szymonkacperek/PSD_Dashboard/Projekt_EAGLE/0.1.brd

## EAGLE design Projekt_EAGLE/0.1.brd (2020-08-10)

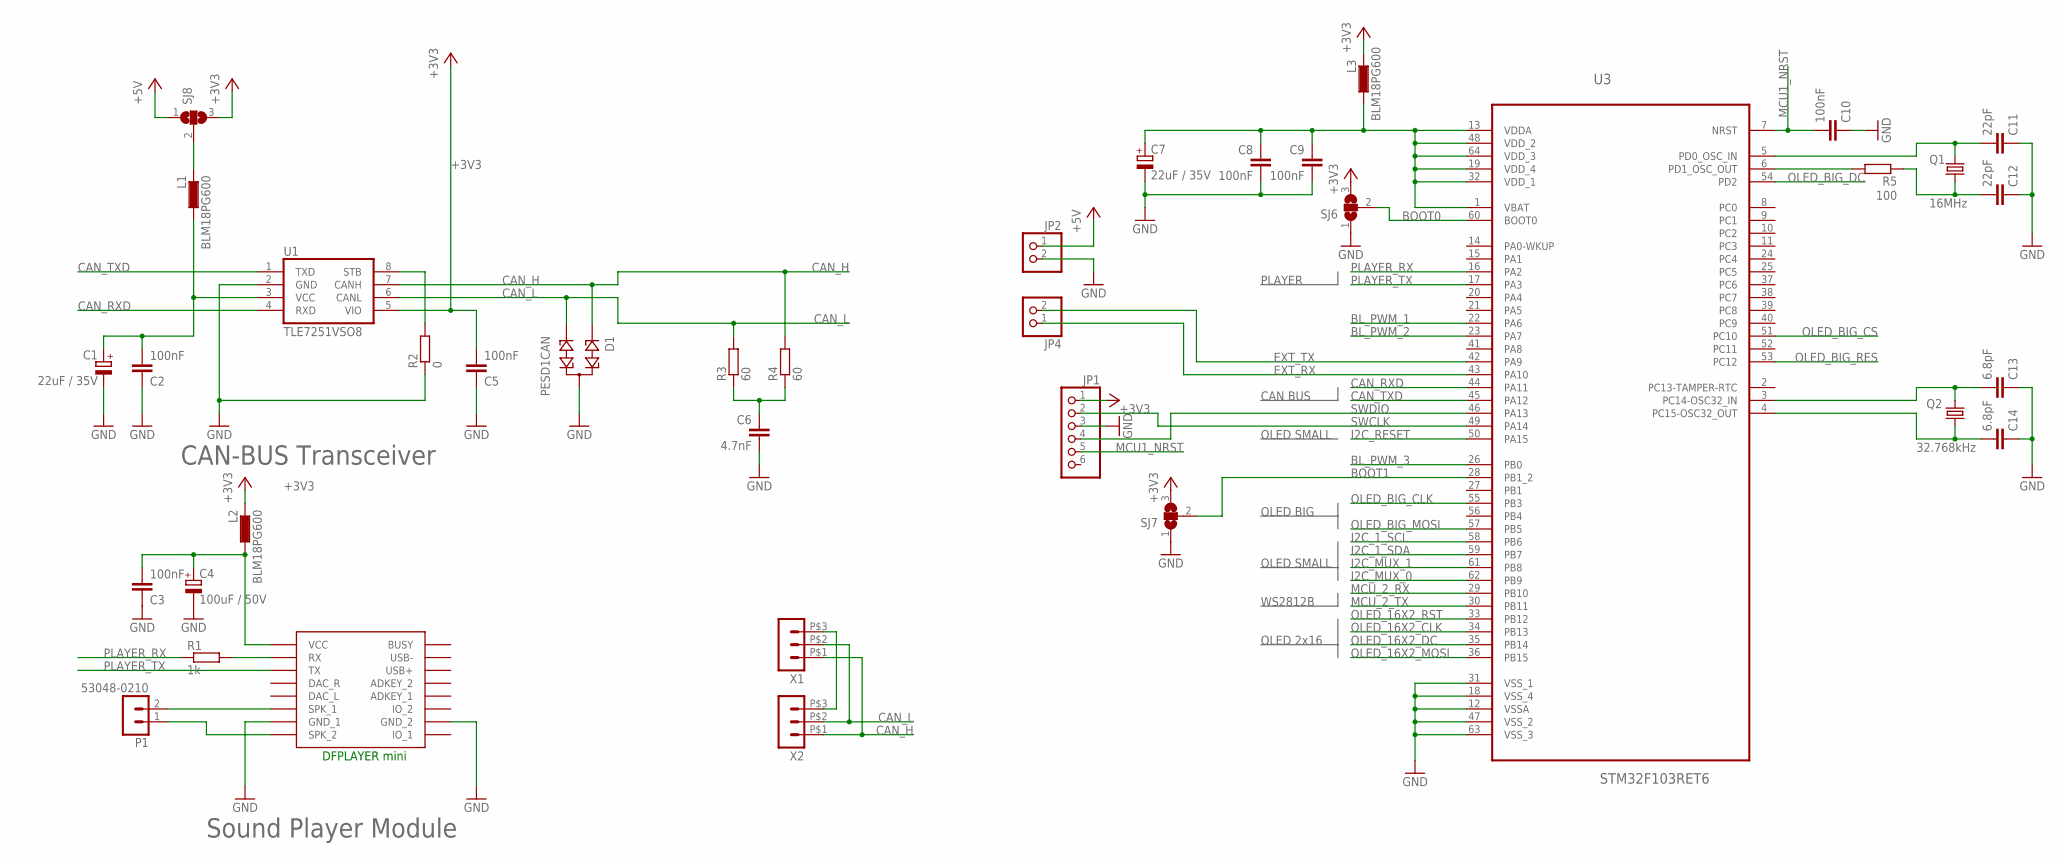
[picture p1: schematic 0.1.sch, sheet 1, MCU]

Parts:
C1, C7: 22uF / 35V; SMC_D
C2, C3, C5, C8, C9, C10: 100nF; C0805K
C4: 100uF / 50V; PANASONIC_F
C6: 4.7nF; C0805K
C11, C12: 22pF; C0805K
C13, C14: 6.8pF; C0805K
D1: PESD1CAN; SOT23
JP1: PINHD-1X6; 1X06
JP2, JP4: PINHD-1X2; 1X02
L1, L2, L3: BLM18PG600; L1608
P1: 53048-0210
Q1: 16MHz; SM49
Q2: 32.768kHz; SMD4_270
R1: 1k; R0805
R2: 0; R0805
R3, R4: 60; R0805
R5: 100; R0805
SJ6, SJ7, SJ8: SJ2W; SJ_2
U1: TLE7251VSO8; SO8
U2: DFPLAYER
U3: STM32F103RET6; QFP50P1200X1200X160-64N
X1, X2: HEADER_POS3_43650-0315; 43650-0315

Connections:
+3V3: C5.2, JP1.1, L2.2, L3.2, SJ6.3, SJ7.3, SJ8.3, U1.5 (VIO); also elsewhere on the board
+5V: JP2.1, SJ8.1; also elsewhere on the board
BL_PWM_1: U3.22 (PA6); also elsewhere on the board
BL_PWM_2: U3.23 (PA7); also elsewhere on the board
BL_PWM_3: U3.26 (PB0); also elsewhere on the board
BOOT0: SJ6.2, U3.60 (BOOT0)
BOOT1: SJ7.2, U3.28 (PB1_2)
CAN_H: D1.1, R4.2, U1.7 (CANH), X1.P$1 (1), X2.P$1 (1)
CAN_L: D1.2, R3.2, U1.6 (CANL), X1.P$2 (2), X2.P$2 (2)
CAN_RXD: U1.4 (RXD), U3.44 (PA11)
CAN_STB: R2.2, U1.8 (STB)
CAN_TXD: U1.1 (TXD), U3.45 (PA12)
EXT_RX: JP4.1, U3.43 (PA10)
EXT_TX: JP4.2, U3.42 (PA9)
GND: C1.-, C2.1, C3.1, C4.-, C5.1, C6.2, C7.-, C8.2, C9.2, C10.1, C11.1, C12.1, C13.1, C14.1, D1.3, JP1.3, JP2.2, R2.1, SJ6.1, SJ7.1, U1.2 (GND), U2.GND_1, U2.GND_2, U3.12 (VSSA), U3.18 (VSS_4), U3.31 (VSS_1), U3.47 (VSS_2), U3.63 (VSS_3); also elsewhere on the board
I2C_1_SCL: U3.58 (PB6); also elsewhere on the board
I2C_1_SDA: U3.59 (PB7); also elsewhere on the board
I2C_MUX_0: U3.62 (PB9); also elsewhere on the board
I2C_MUX_1: U3.61 (PB8); also elsewhere on the board
I2C_RESET: U3.50 (PA15); also elsewhere on the board
MCU1_NRST: C10.2, JP1.5, U3.7 (NRST)
MCU_2_RX: U3.29 (PB10); also elsewhere on the board
MCU_2_TX: U3.30 (PB11); also elsewhere on the board
unnamed: R5.2, U3.6 (PD1_OSC_OUT)
unnamed: R1.2, U2.RX
unnamed: C3.2, C4.+, L2.1, U2.VCC
unnamed: X1.P$3 (3), X2.P$3 (3)
unnamed: P1.1, U2.SPK2 (SPK_2)
unnamed: C6.1, R3.1, R4.1
unnamed: C7.+, C8.1, C9.1, L3.1, U3.1 (VBAT), U3.13 (VDDA), U3.19 (VDD_4), U3.32 (VDD_1), U3.48 (VDD_2), U3.64 (VDD_3)
unnamed: P1.2, U2.SPK1 (SPK_1)
unnamed: L1.2, SJ8.2
unnamed: C11.2, Q1.1, U3.5 (PD0_OSC_IN)
unnamed: C12.2, Q1.2, R5.1
unnamed: C13.2, Q2.4 (2), U3.3 (PC14-OSC32_IN)
unnamed: C14.2, Q2.1, U3.4 (PC15-OSC32_OUT)
unnamed: C1.+, C2.2, L1.1, U1.3 (VCC)
OLED_16X2_CLK: U3.34 (PB13); also elsewhere on the board
OLED_16X2_DC: U3.35 (PB14); also elsewhere on the board
OLED_16X2_MOSI: U3.36 (PB15); also elsewhere on the board
OLED_16X2_RST: U3.33 (PB12); also elsewhere on the board
OLED_BIG_CLK: U3.55 (PB3); also elsewhere on the board
OLED_BIG_CS: U3.51 (PC10); also elsewhere on the board
OLED_BIG_DC: U3.54 (PD2); also elsewhere on the board
OLED_BIG_MOSI: U3.57 (PB5); also elsewhere on the board
OLED_BIG_RES: U3.53 (PC12); also elsewhere on the board
PLAYER_RX: R1.1, U3.16 (PA2)
PLAYER_TX: U2.TX, U3.17 (PA3)
SWCLK: JP1.2, U3.49 (PA14)
SWDIO: JP1.4, U3.46 (PA13)

Notes on the sheet:
CAN-BUS Transceiver
Sound Player Module
OLED 2x16
OLED BIG
OLED SMALL
PLAYER
WS2812B
CAN BUS
DFPLAYER mini

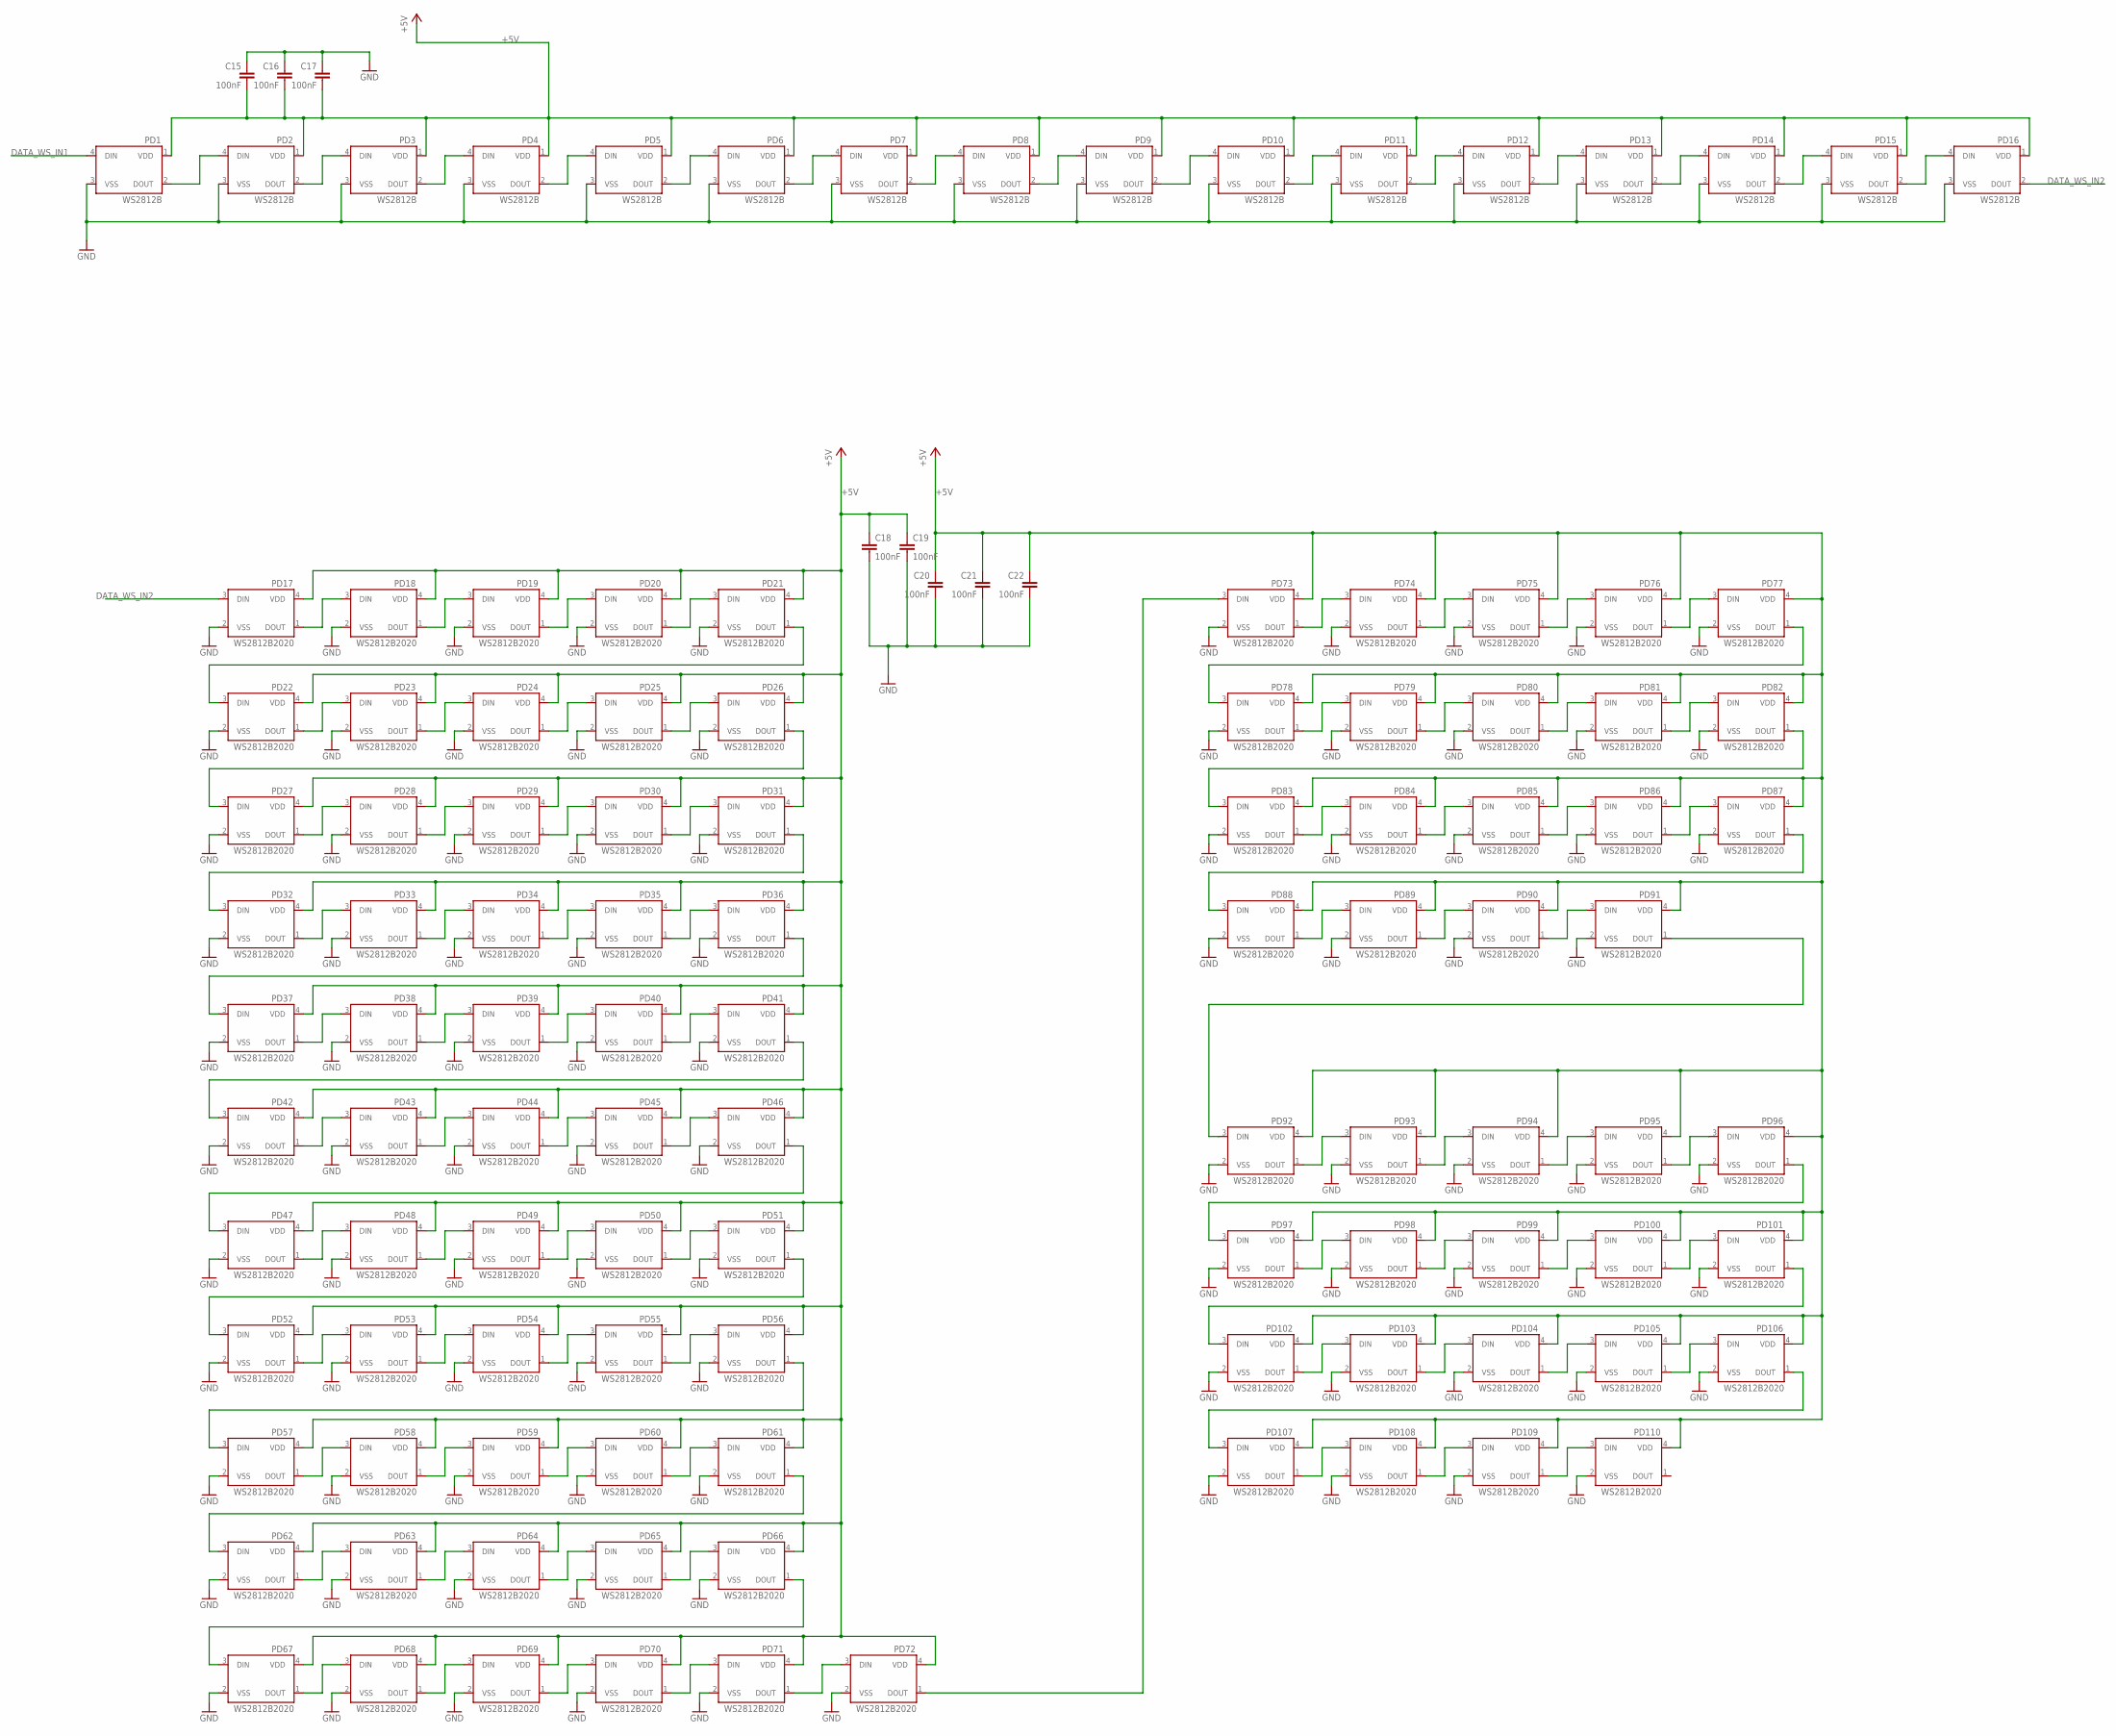
[picture p2: schematic 0.1.sch, sheet 2, WS2812b arrays]

Parts:
C15, C16, C17, C18, C19, C20, C21, C22: 100nF; C0805K
PD1, PD2, PD3, PD4, PD5, PD6, PD7, PD8, PD9, PD10, PD11, PD12, PD13, PD14, PD15, PD16: WS2812B; 5050
PD17, PD18, PD19, PD20, PD21, PD22, PD23, PD24, PD25, PD26, PD27, PD28, PD29, PD30, PD31, PD32, PD33, PD34, PD35, PD36, PD37, PD38, PD39, PD40, PD41, PD42, PD43, PD44, PD45, PD46, PD47, PD48, PD49, PD50, PD51, PD52, PD53, PD54, PD55, PD56, PD57, PD58, PD59, PD60, PD61, PD62, PD63, PD64, PD65, PD66, PD67, PD68, PD69, PD70, PD71, PD72, PD73, PD74, PD75, PD76, PD77, PD78, PD79, PD80, PD81, PD82, PD83, PD84, PD85, PD86, PD87, PD88, PD89, PD90, PD91, PD92, PD93, PD94, PD95, PD96, PD97, PD98, PD99, PD100, PD101, PD102, PD103, PD104, PD105, PD106, PD107, PD108, PD109, PD110: WS2812B2020; LED_WS2812-2020

Connections:
+5V: C15.2, C16.2, C17.2, C18.1, C19.1, C20.1, C21.1, C22.1, PD1.1 (VDD), PD2.1 (VDD), PD3.1 (VDD), PD4.1 (VDD), PD5.1 (VDD), PD6.1 (VDD), PD7.1 (VDD), PD8.1 (VDD), PD9.1 (VDD), PD10.1 (VDD), PD11.1 (VDD), PD12.1 (VDD), PD13.1 (VDD), PD14.1 (VDD), PD15.1 (VDD), PD16.1 (VDD), PD17.4 (VDD), PD18.4 (VDD), PD19.4 (VDD), PD20.4 (VDD), PD21.4 (VDD), PD22.4 (VDD), PD23.4 (VDD), PD24.4 (VDD), PD25.4 (VDD), PD26.4 (VDD), PD27.4 (VDD), PD28.4 (VDD), PD29.4 (VDD), PD30.4 (VDD), PD31.4 (VDD), PD32.4 (VDD), PD33.4 (VDD), PD34.4 (VDD), PD35.4 (VDD), PD36.4 (VDD), PD37.4 (VDD), PD38.4 (VDD), PD39.4 (VDD), PD40.4 (VDD), PD41.4 (VDD), PD42.4 (VDD), PD43.4 (VDD), PD44.4 (VDD), PD45.4 (VDD), PD46.4 (VDD), PD47.4 (VDD), PD48.4 (VDD), PD49.4 (VDD), PD50.4 (VDD), PD51.4 (VDD), PD52.4 (VDD), PD53.4 (VDD), PD54.4 (VDD), PD55.4 (VDD), PD56.4 (VDD), PD57.4 (VDD), PD58.4 (VDD), PD59.4 (VDD), PD60.4 (VDD), PD61.4 (VDD), PD62.4 (VDD), PD63.4 (VDD), PD64.4 (VDD), PD65.4 (VDD), PD66.4 (VDD), PD67.4 (VDD), PD68.4 (VDD), PD69.4 (VDD), PD70.4 (VDD), PD71.4 (VDD), PD72.4 (VDD), PD73.4 (VDD), PD74.4 (VDD), PD75.4 (VDD), PD76.4 (VDD), PD77.4 (VDD), PD78.4 (VDD), PD79.4 (VDD), PD80.4 (VDD), PD81.4 (VDD), PD82.4 (VDD), PD83.4 (VDD), PD84.4 (VDD), PD85.4 (VDD), PD86.4 (VDD), PD87.4 (VDD), PD88.4 (VDD), PD89.4 (VDD), PD90.4 (VDD), PD91.4 (VDD), PD92.4 (VDD), PD93.4 (VDD), PD94.4 (VDD), PD95.4 (VDD), PD96.4 (VDD), PD97.4 (VDD), PD98.4 (VDD), PD99.4 (VDD), PD100.4 (VDD), PD101.4 (VDD), PD102.4 (VDD), PD103.4 (VDD), PD104.4 (VDD), PD105.4 (VDD), PD106.4 (VDD), PD107.4 (VDD), PD108.4 (VDD), PD109.4 (VDD), PD110.4 (VDD); also elsewhere on the board
DATA_WS_IN1: PD1.4 (DIN); also elsewhere on the board
DATA_WS_IN2: PD16.2 (DOUT), PD17.3 (DIN)
DATA_WS_IN3: PD72.1 (DOUT), PD73.3 (DIN)
GND: C15.1, C16.1, C17.1, C18.2, C19.2, C20.2, C21.2, C22.2, PD1.3 (VSS), PD2.3 (VSS), PD3.3 (VSS), PD4.3 (VSS), PD5.3 (VSS), PD6.3 (VSS), PD7.3 (VSS), PD8.3 (VSS), PD9.3 (VSS), PD10.3 (VSS), PD11.3 (VSS), PD12.3 (VSS), PD13.3 (VSS), PD14.3 (VSS), PD15.3 (VSS), PD16.3 (VSS), PD17.2 (VSS), PD18.2 (VSS), PD19.2 (VSS), PD20.2 (VSS), PD21.2 (VSS), PD22.2 (VSS), PD23.2 (VSS), PD24.2 (VSS), PD25.2 (VSS), PD26.2 (VSS), PD27.2 (VSS), PD28.2 (VSS), PD29.2 (VSS), PD30.2 (VSS), PD31.2 (VSS), PD32.2 (VSS), PD33.2 (VSS), PD34.2 (VSS), PD35.2 (VSS), PD36.2 (VSS), PD37.2 (VSS), PD38.2 (VSS), PD39.2 (VSS), PD40.2 (VSS), PD41.2 (VSS), PD42.2 (VSS), PD43.2 (VSS), PD44.2 (VSS), PD45.2 (VSS), PD46.2 (VSS), PD47.2 (VSS), PD48.2 (VSS), PD49.2 (VSS), PD50.2 (VSS), PD51.2 (VSS), PD52.2 (VSS), PD53.2 (VSS), PD54.2 (VSS), PD55.2 (VSS), PD56.2 (VSS), PD57.2 (VSS), PD58.2 (VSS), PD59.2 (VSS), PD60.2 (VSS), PD61.2 (VSS), PD62.2 (VSS), PD63.2 (VSS), PD64.2 (VSS), PD65.2 (VSS), PD66.2 (VSS), PD67.2 (VSS), PD68.2 (VSS), PD69.2 (VSS), PD70.2 (VSS), PD71.2 (VSS), PD72.2 (VSS), PD73.2 (VSS), PD74.2 (VSS), PD75.2 (VSS), PD76.2 (VSS), PD77.2 (VSS), PD78.2 (VSS), PD79.2 (VSS), PD80.2 (VSS), PD81.2 (VSS), PD82.2 (VSS), PD83.2 (VSS), PD84.2 (VSS), PD85.2 (VSS), PD86.2 (VSS), PD87.2 (VSS), PD88.2 (VSS), PD89.2 (VSS), PD90.2 (VSS), PD91.2 (VSS), PD92.2 (VSS), PD93.2 (VSS), PD94.2 (VSS), PD95.2 (VSS), PD96.2 (VSS), PD97.2 (VSS), PD98.2 (VSS), PD99.2 (VSS), PD100.2 (VSS), PD101.2 (VSS), PD102.2 (VSS), PD103.2 (VSS), PD104.2 (VSS), PD105.2 (VSS), PD106.2 (VSS), PD107.2 (VSS), PD108.2 (VSS), PD109.2 (VSS), PD110.2 (VSS); also elsewhere on the board
unnamed: PD1.2 (DOUT), PD2.4 (DIN)
unnamed: PD2.2 (DOUT), PD3.4 (DIN)
unnamed: PD3.2 (DOUT), PD4.4 (DIN)
unnamed: PD4.2 (DOUT), PD5.4 (DIN)
unnamed: PD5.2 (DOUT), PD6.4 (DIN)
unnamed: PD6.2 (DOUT), PD7.4 (DIN)
unnamed: PD7.2 (DOUT), PD8.4 (DIN)
unnamed: PD9.2 (DOUT), PD10.4 (DIN)
unnamed: PD10.2 (DOUT), PD11.4 (DIN)
unnamed: PD11.2 (DOUT), PD12.4 (DIN)
unnamed: PD12.2 (DOUT), PD13.4 (DIN)
unnamed: PD13.2 (DOUT), PD14.4 (DIN)
unnamed: PD14.2 (DOUT), PD15.4 (DIN)
unnamed: PD15.2 (DOUT), PD16.4 (DIN)
unnamed: PD8.2 (DOUT), PD9.4 (DIN)
unnamed: PD21.1 (DOUT), PD22.3 (DIN)
unnamed: PD17.1 (DOUT), PD18.3 (DIN)
unnamed: PD18.1 (DOUT), PD19.3 (DIN)
unnamed: PD19.1 (DOUT), PD20.3 (DIN)
unnamed: PD20.1 (DOUT), PD21.3 (DIN)
unnamed: PD22.1 (DOUT), PD23.3 (DIN)
unnamed: PD23.1 (DOUT), PD24.3 (DIN)
unnamed: PD24.1 (DOUT), PD25.3 (DIN)
unnamed: PD25.1 (DOUT), PD26.3 (DIN)
unnamed: PD26.1 (DOUT), PD27.3 (DIN)
unnamed: PD27.1 (DOUT), PD28.3 (DIN)
unnamed: PD28.1 (DOUT), PD29.3 (DIN)
unnamed: PD29.1 (DOUT), PD30.3 (DIN)
unnamed: PD30.1 (DOUT), PD31.3 (DIN)
unnamed: PD31.1 (DOUT), PD32.3 (DIN)
unnamed: PD32.1 (DOUT), PD33.3 (DIN)
unnamed: PD33.1 (DOUT), PD34.3 (DIN)
unnamed: PD34.1 (DOUT), PD35.3 (DIN)
unnamed: PD35.1 (DOUT), PD36.3 (DIN)
unnamed: PD36.1 (DOUT), PD37.3 (DIN)
unnamed: PD37.1 (DOUT), PD38.3 (DIN)
unnamed: PD38.1 (DOUT), PD39.3 (DIN)
unnamed: PD39.1 (DOUT), PD40.3 (DIN)
unnamed: PD40.1 (DOUT), PD41.3 (DIN)
unnamed: PD41.1 (DOUT), PD42.3 (DIN)
unnamed: PD42.1 (DOUT), PD43.3 (DIN)
unnamed: PD43.1 (DOUT), PD44.3 (DIN)
unnamed: PD44.1 (DOUT), PD45.3 (DIN)
unnamed: PD45.1 (DOUT), PD46.3 (DIN)
unnamed: PD46.1 (DOUT), PD47.3 (DIN)
unnamed: PD47.1 (DOUT), PD48.3 (DIN)
unnamed: PD48.1 (DOUT), PD49.3 (DIN)
unnamed: PD49.1 (DOUT), PD50.3 (DIN)
unnamed: PD50.1 (DOUT), PD51.3 (DIN)
unnamed: PD51.1 (DOUT), PD52.3 (DIN)
unnamed: PD52.1 (DOUT), PD53.3 (DIN)
unnamed: PD53.1 (DOUT), PD54.3 (DIN)
unnamed: PD54.1 (DOUT), PD55.3 (DIN)
unnamed: PD55.1 (DOUT), PD56.3 (DIN)
unnamed: PD56.1 (DOUT), PD57.3 (DIN)
unnamed: PD57.1 (DOUT), PD58.3 (DIN)
unnamed: PD58.1 (DOUT), PD59.3 (DIN)
unnamed: PD59.1 (DOUT), PD60.3 (DIN)
unnamed: PD60.1 (DOUT), PD61.3 (DIN)
unnamed: PD61.1 (DOUT), PD62.3 (DIN)
unnamed: PD62.1 (DOUT), PD63.3 (DIN)
unnamed: PD63.1 (DOUT), PD64.3 (DIN)
unnamed: PD64.1 (DOUT), PD65.3 (DIN)
unnamed: PD65.1 (DOUT), PD66.3 (DIN)
unnamed: PD66.1 (DOUT), PD67.3 (DIN)
unnamed: PD92.1 (DOUT), PD93.3 (DIN)
unnamed: PD67.1 (DOUT), PD68.3 (DIN)
unnamed: PD68.1 (DOUT), PD69.3 (DIN)
unnamed: PD69.1 (DOUT), PD70.3 (DIN)
unnamed: PD70.1 (DOUT), PD71.3 (DIN)
unnamed: PD71.1 (DOUT), PD72.3 (DIN)
unnamed: PD93.1 (DOUT), PD94.3 (DIN)
unnamed: PD94.1 (DOUT), PD95.3 (DIN)
unnamed: PD95.1 (DOUT), PD96.3 (DIN)
unnamed: PD73.1 (DOUT), PD74.3 (DIN)
unnamed: PD74.1 (DOUT), PD75.3 (DIN)
unnamed: PD75.1 (DOUT), PD76.3 (DIN)
unnamed: PD76.1 (DOUT), PD77.3 (DIN)
unnamed: PD77.1 (DOUT), PD78.3 (DIN)
unnamed: PD78.1 (DOUT), PD79.3 (DIN)
unnamed: PD79.1 (DOUT), PD80.3 (DIN)
unnamed: PD80.1 (DOUT), PD81.3 (DIN)
unnamed: PD81.1 (DOUT), PD82.3 (DIN)
unnamed: PD82.1 (DOUT), PD83.3 (DIN)
unnamed: PD83.1 (DOUT), PD84.3 (DIN)
unnamed: PD84.1 (DOUT), PD85.3 (DIN)
unnamed: PD85.1 (DOUT), PD86.3 (DIN)
unnamed: PD86.1 (DOUT), PD87.3 (DIN)
unnamed: PD87.1 (DOUT), PD88.3 (DIN)
unnamed: PD88.1 (DOUT), PD89.3 (DIN)
unnamed: PD89.1 (DOUT), PD90.3 (DIN)
unnamed: PD90.1 (DOUT), PD91.3 (DIN)
unnamed: PD91.1 (DOUT), PD92.3 (DIN)
unnamed: PD96.1 (DOUT), PD97.3 (DIN)
unnamed: PD97.1 (DOUT), PD98.3 (DIN)
unnamed: PD98.1 (DOUT), PD99.3 (DIN)
unnamed: PD99.1 (DOUT), PD100.3 (DIN)
unnamed: PD100.1 (DOUT), PD101.3 (DIN)
unnamed: PD101.1 (DOUT), PD102.3 (DIN)
unnamed: PD102.1 (DOUT), PD103.3 (DIN)
unnamed: PD103.1 (DOUT), PD104.3 (DIN)
unnamed: PD104.1 (DOUT), PD105.3 (DIN)
unnamed: PD105.1 (DOUT), PD106.3 (DIN)
unnamed: PD106.1 (DOUT), PD107.3 (DIN)
unnamed: PD107.1 (DOUT), PD108.3 (DIN)
unnamed: PD108.1 (DOUT), PD109.3 (DIN)
unnamed: PD109.1 (DOUT), PD110.3 (DIN)

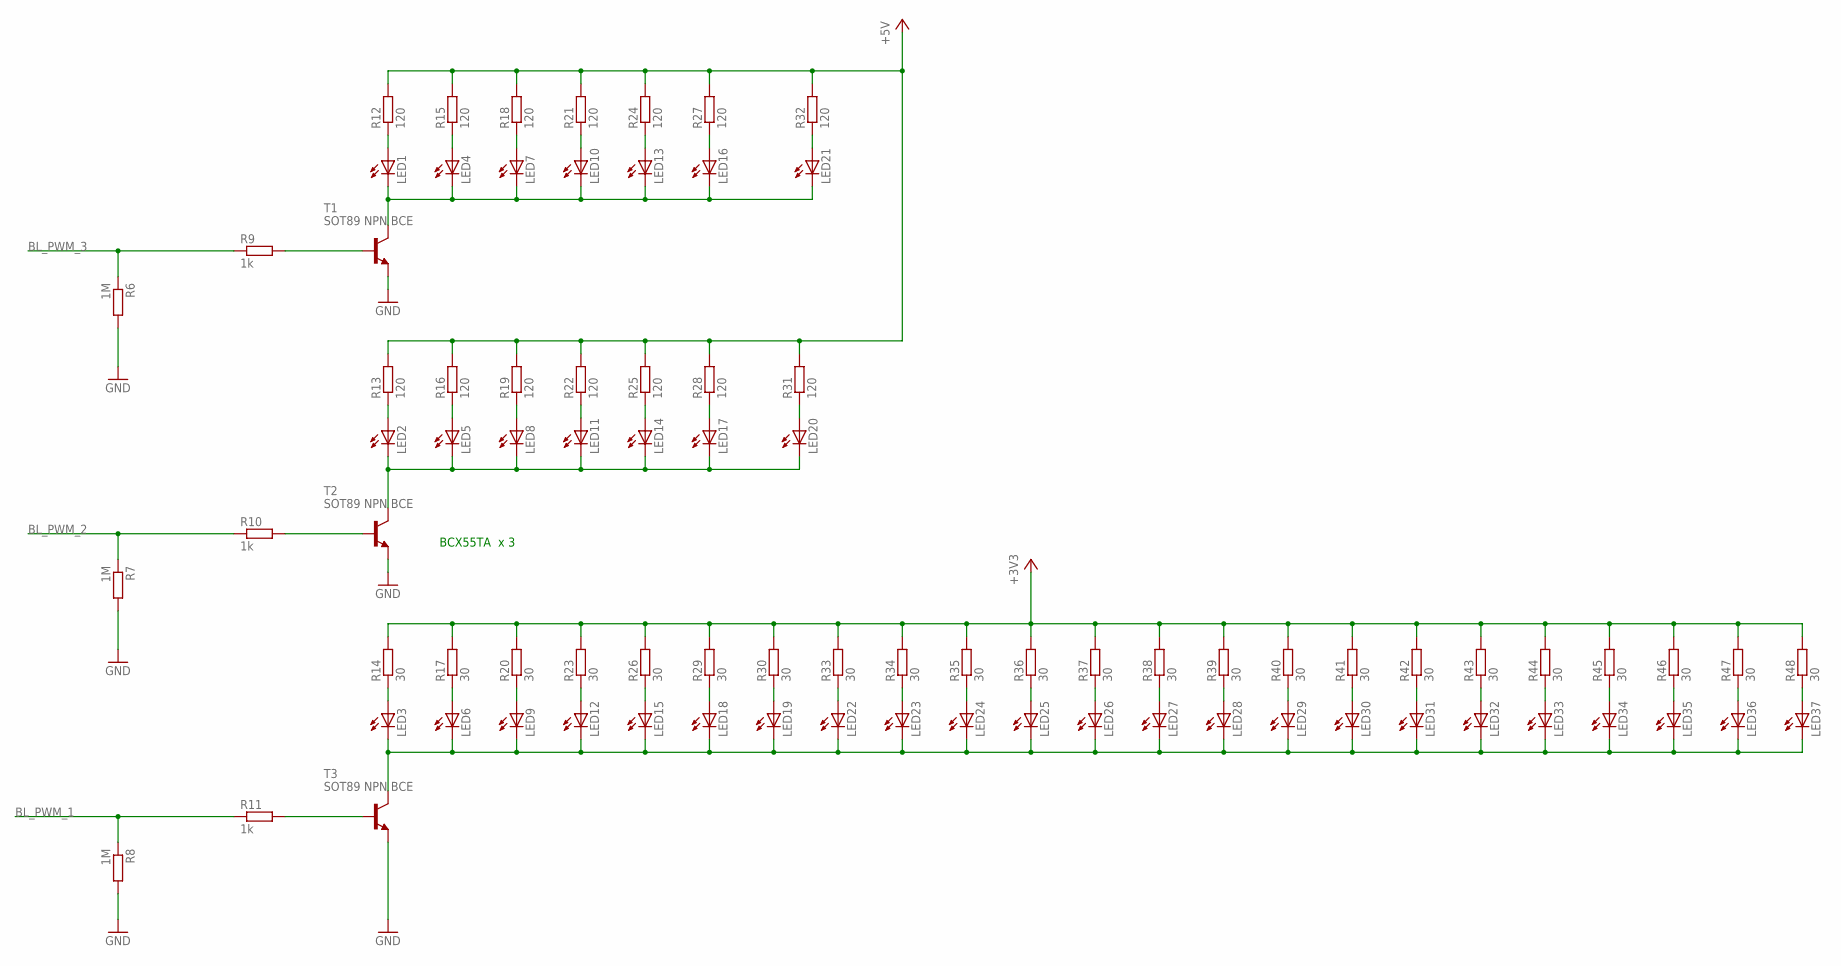
[picture p3: schematic 0.1.sch, sheet 3, backlight]

Parts:
LED1, LED2, LED3, LED4, LED5, LED6, LED7, LED8, LED9, LED10, LED11, LED12, LED13, LED14, LED15, LED16, LED17, LED18, LED19, LED20, LED21, LED22, LED23, LED24, LED25, LED26, LED27, LED28, LED29, LED30, LED31, LED32, LED33, LED34, LED35, LED36, LED37: LEDCHIPLED_0603; CHIPLED_0603
R6, R7, R8: 1M; R0805
R9, R10, R11: 1k; R0805
R12, R13, R15, R16, R18, R19, R21, R22, R24, R25, R27, R28, R31, R32: 120; R0805
R14, R17, R20, R23, R26, R29, R30, R33, R34, R35, R36, R37, R38, R39, R40, R41, R42, R43, R44, R45, R46, R47, R48: 30; R0805
T1, T2, T3: SOT89 NPN BCE; SOT89-BCE

Connections:
+3V3: R14.2, R17.2, R20.2, R23.2, R26.2, R29.2, R30.2, R33.2, R34.2, R35.2, R36.2, R37.2, R38.2, R39.2, R40.2, R41.2, R42.2, R43.2, R44.2, R45.2, R46.2, R47.2, R48.2; also elsewhere on the board
+5V: R12.2, R13.2, R15.2, R16.2, R18.2, R19.2, R21.2, R22.2, R24.2, R25.2, R27.2, R28.2, R31.2, R32.2; also elsewhere on the board
BL_PWM_1: R8.1, R11.1; also elsewhere on the board
BL_PWM_2: R7.1, R10.1; also elsewhere on the board
BL_PWM_3: R6.1, R9.1; also elsewhere on the board
GND: R6.2, R7.2, R8.2, T1.E, T2.E, T3.E; also elsewhere on the board
unnamed: LED1.C, LED4.C, LED7.C, LED10.C, LED13.C, LED16.C, LED21.C, T1.C
unnamed: LED2.C, LED5.C, LED8.C, LED11.C, LED14.C, LED17.C, LED20.C, T2.C
unnamed: R9.2, T1.B
unnamed: R10.2, T2.B
unnamed: R11.2, T3.B
unnamed: LED1.A, R12.1
unnamed: LED4.A, R15.1
unnamed: LED7.A, R18.1
unnamed: LED10.A, R21.1
unnamed: LED13.A, R24.1
unnamed: LED16.A, R27.1
unnamed: LED23.A, R34.1
unnamed: LED24.A, R35.1
unnamed: LED25.A, R36.1
unnamed: LED26.A, R37.1
unnamed: LED27.A, R38.1
unnamed: LED28.A, R39.1
unnamed: LED29.A, R40.1
unnamed: LED3.C, LED6.C, LED9.C, LED12.C, LED15.C, LED18.C, LED19.C, LED22.C, LED23.C, LED24.C, LED25.C, LED26.C, LED27.C, LED28.C, LED29.C, LED30.C, LED31.C, LED32.C, LED33.C, LED34.C, LED35.C, LED36.C, LED37.C, T3.C
unnamed: LED3.A, R14.1
unnamed: LED2.A, R13.1
unnamed: LED5.A, R16.1
unnamed: LED8.A, R19.1
unnamed: LED11.A, R22.1
unnamed: LED14.A, R25.1
unnamed: LED17.A, R28.1
unnamed: LED30.A, R41.1
unnamed: LED21.A, R32.1
unnamed: LED20.A, R31.1
unnamed: LED6.A, R17.1
unnamed: LED9.A, R20.1
unnamed: LED12.A, R23.1
unnamed: LED31.A, R42.1
unnamed: LED15.A, R26.1
unnamed: LED18.A, R29.1
unnamed: LED19.A, R30.1
unnamed: LED22.A, R33.1
unnamed: LED32.A, R43.1
unnamed: LED33.A, R44.1
unnamed: LED34.A, R45.1
unnamed: LED35.A, R46.1
unnamed: LED36.A, R47.1
unnamed: LED37.A, R48.1

Notes on the sheet:
BCX55TA x 3

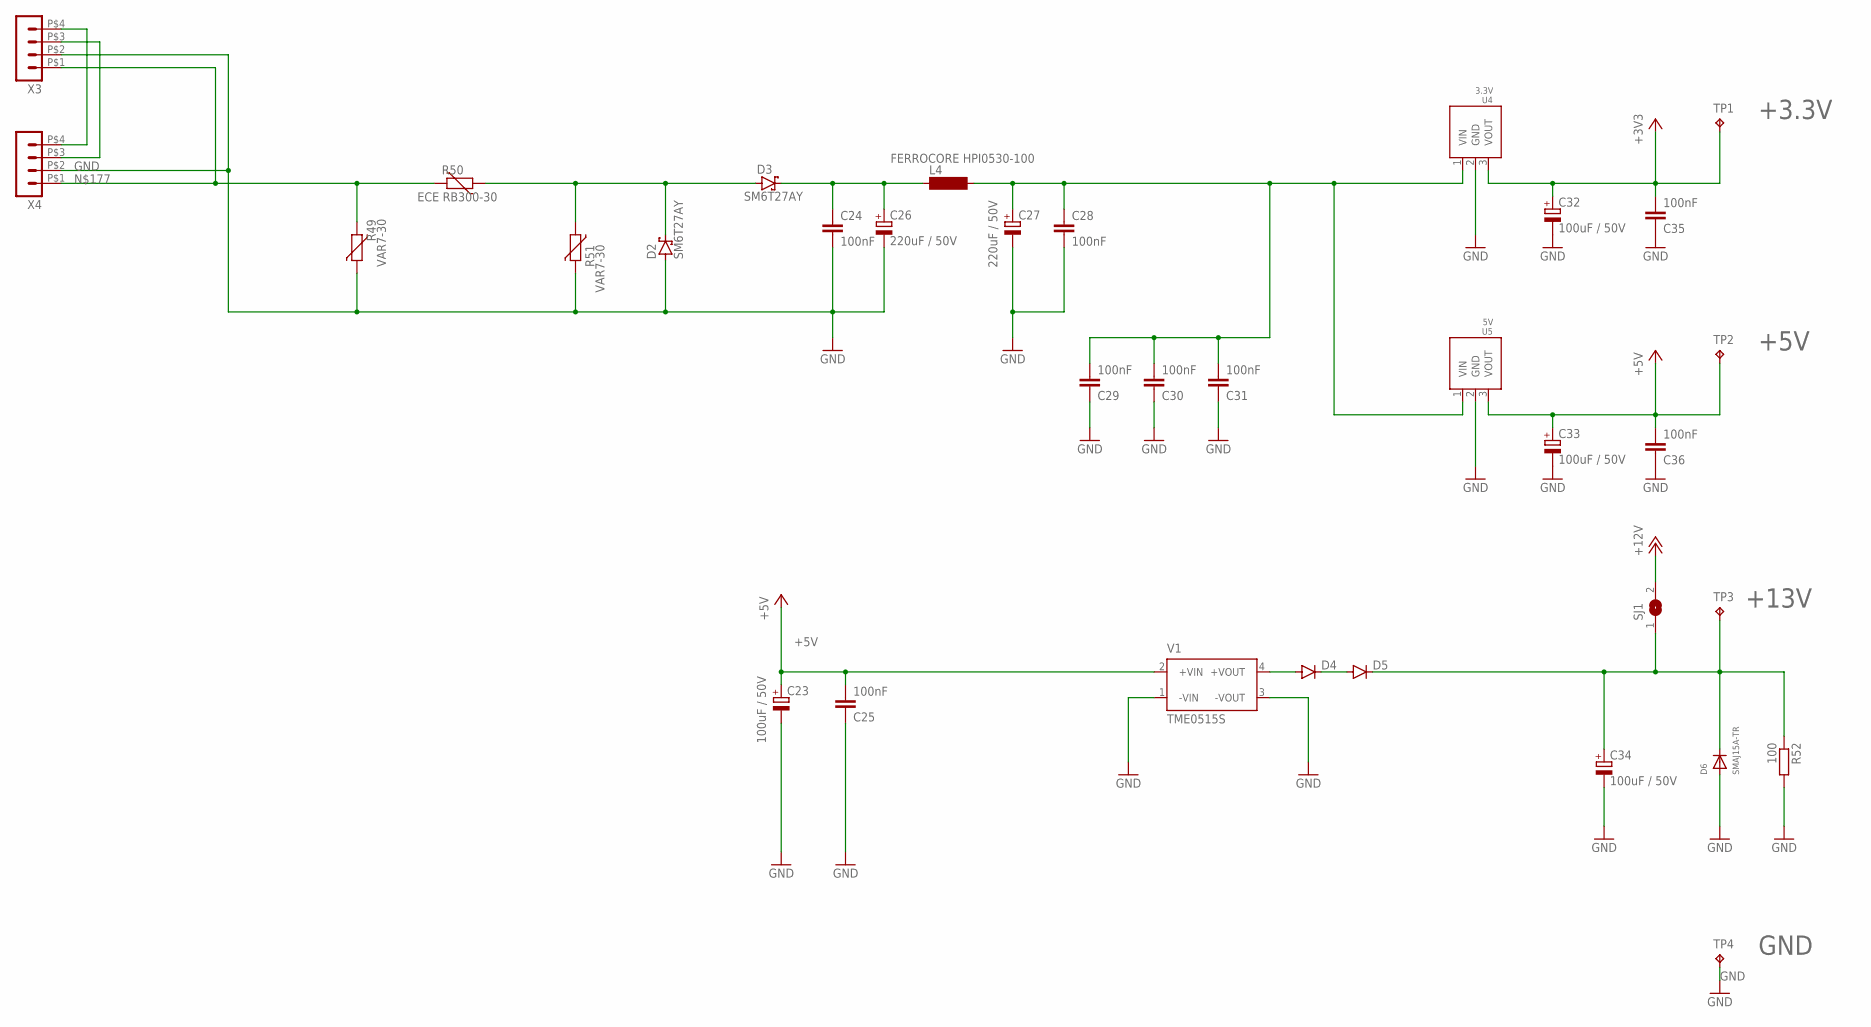
[picture p4: schematic 0.1.sch, sheet 4, power supply]

Parts:
C23, C32, C33, C34: 100uF / 50V; PANASONIC_F
C24, C28: 100nF; C1206K
C25, C29, C30, C31, C35, C36: 100nF; C0805K
C26, C27: 220uF / 50V; PANASONIC_G
D2, D3: SM6T27AY; SMB
D4, D5: DIODE-SOD123; SOD123
D6: SMAJ15A-TR; SMADIODE
L4: FERROCORE HPI0530-100; MS85
R49, R51: VAR7-30; S07K11
R50: ECE RB300-30; S07K11
R52: 100; R0805
SJ1: SJ
TP1: 3V3; TP18SQ
TP2: 5V; TP18SQ
TP3: 12V; TP18SQ
TP4: GND; TP18SQ
U4: 3.3V; FDSM-173XXXX42
U5: 5V; FDSM-173XXXX42
V1: TME0515S; TME
X3, X4: HEADER_POS4_43045-0412; 43045-0412

Connections:
+3V3: C32.+, C35.2, TP1.TP, U4.3 (VOUT); also elsewhere on the board
+5V: C23.+, C25.2, C33.+, C36.2, TP2.TP, U5.3 (VOUT), V1.2 (+VIN); also elsewhere on the board
+12V: SJ1.2; also elsewhere on the board
GND: C23.-, C24.2, C25.1, C26.-, C27.-, C28.2, C29.1, C30.1, C31.1, C32.-, C33.-, C34.-, C35.1, C36.1, D2.A, D6.A, R49.2, R51.2, R52.2, TP4.TP, U4.2 (GND), U5.2 (GND), V1.1 (-VIN), V1.3 (-VOUT), X3.P$2 (2), X4.P$2 (2); also elsewhere on the board
unnamed: C27.+, C28.1, C29.2, C30.2, C31.2, L4.2, U4.1 (VIN), U5.1 (VIN)
unnamed: D2.C, D3.A, R50.1, R51.1
unnamed: D4.A, V1.4 (+VOUT)
unnamed: D4.C, D5.A
unnamed: C24.1, C26.+, D3.C, L4.1
unnamed: C34.+, D5.C, D6.C, R52.1, SJ1.1, TP3.TP
unnamed: X3.P$4 (4), X4.P$4 (4)
unnamed: X3.P$3 (3), X4.P$3 (3)
unnamed: R49.1, R50.2, X3.P$1 (1), X4.P$1 (1)

Notes on the sheet:
+3.3V
+5V
GND
+13V

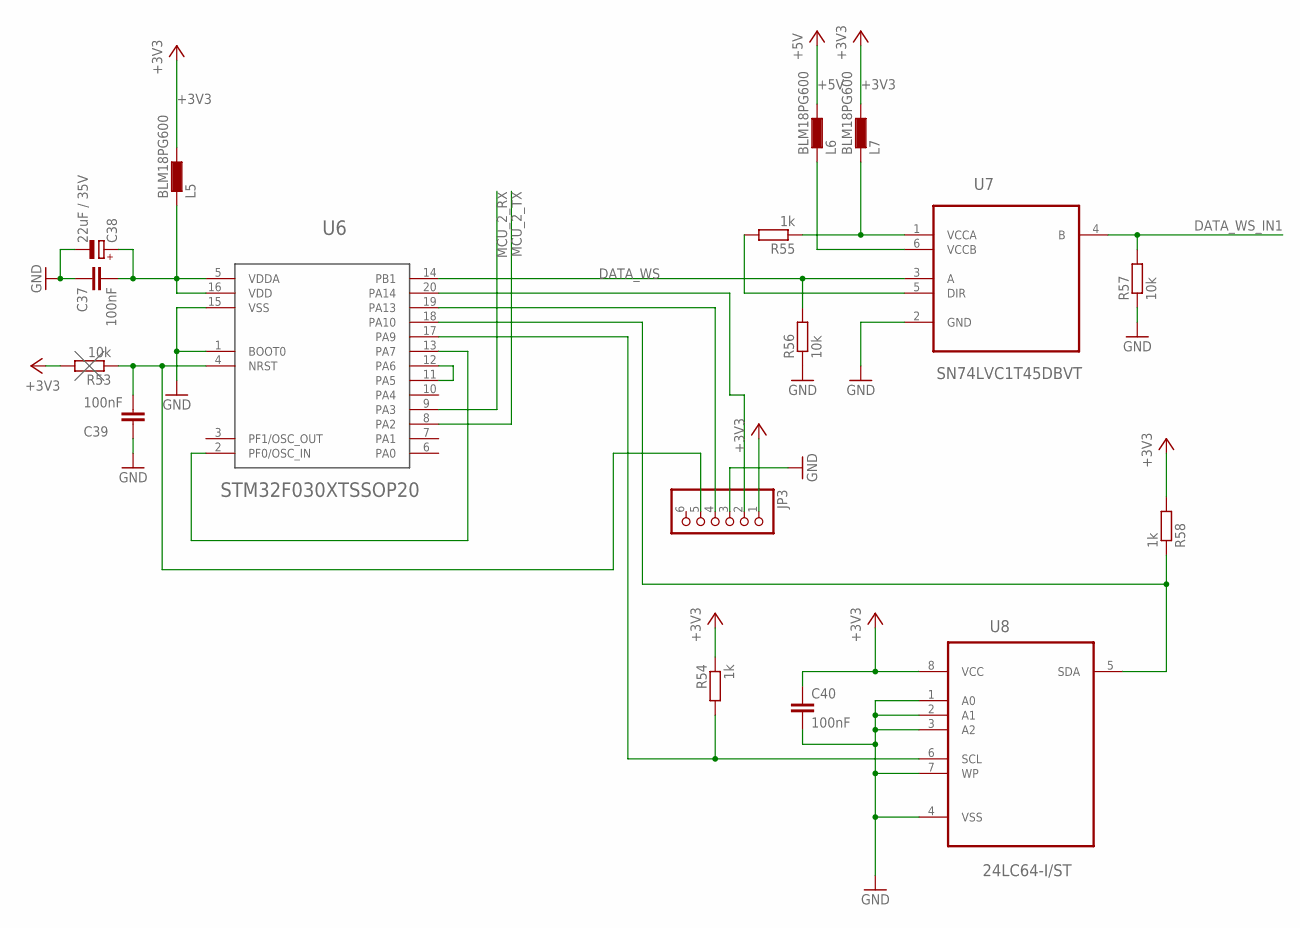
[picture p5: schematic 0.1.sch, sheet 5, WS2812B controller]

Parts:
C37, C39, C40: 100nF; C0805K
C38: 22uF / 35V; SMC_D
JP3: PINHD-1X6; 1X06
L5, L6, L7: BLM18PG600; L1608
R53, R56, R57: 10k; R0805
R54, R55, R58: 1k; R0805
U6: STM32F030XTSSOP20; TSSOP-20
U7: SN74LVC1T45DBVT; SOT95P280X145-6N
U8: 24LC64-I/ST; SOP65P638X110-8N

Connections:
+3V3: C40.1, JP3.1, L5.1, L7.1, R53.2, R54.1, R58.2, U8.8 (VCC); also elsewhere on the board
+5V: L6.1; also elsewhere on the board
DATA_WS: R56.2, U6.14 (PB1), U7.3 (A)
DATA_WS_IN1: R57.2, U7.4 (B); also elsewhere on the board
GND: C37.1, C38.-, C39.1, C40.2, JP3.3, R56.1, R57.1, U6.1 (BOOT0), U6.15 (VSS), U7.2 (GND), U8.1 (A0), U8.2 (A1), U8.3 (A2), U8.4 (VSS), U8.7 (WP); also elsewhere on the board
MCU_2_RX: U6.9 (PA3); also elsewhere on the board
MCU_2_TX: U6.8 (PA2); also elsewhere on the board
unnamed: R55.2, U7.5 (DIR)
unnamed: L7.2, R55.1, U7.1 (VCCA)
unnamed: L6.2, U7.6 (VCCB)
unnamed: C39.2, JP3.5, R53.1, U6.4 (NRST)
unnamed: U6.2 (PF0/OSC_IN), U6.13 (PA7)
unnamed: U6.11 (PA5), U6.12 (PA6)
unnamed: JP3.4, U6.19 (PA13)
unnamed: JP3.2, U6.20 (PA14)
unnamed: R58.1, U6.18 (PA10), U8.5 (SDA)
unnamed: R54.2, U6.17 (PA9), U8.6 (SCL)
unnamed: C37.2, C38.+, L5.2, U6.5 (VDDA), U6.16 (VDD)

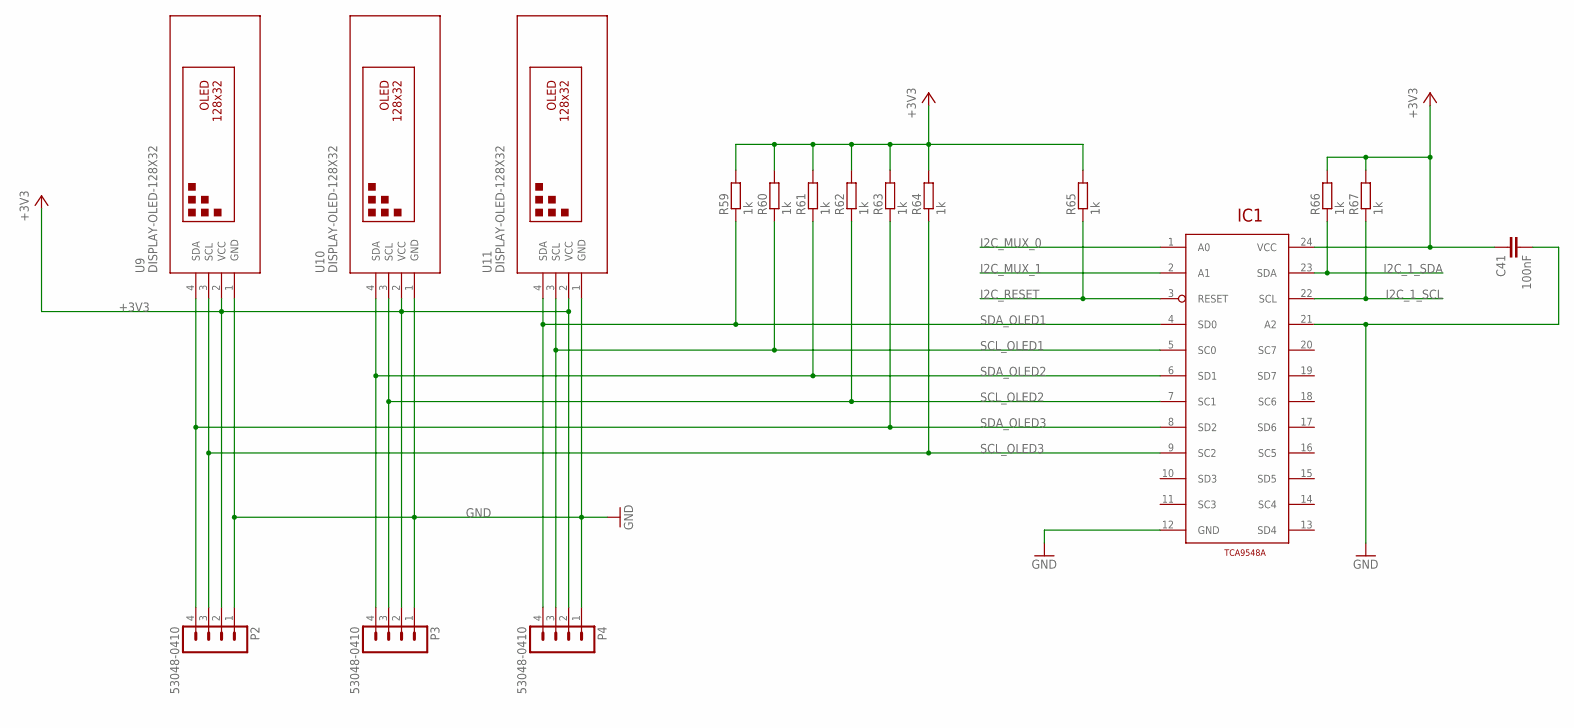
[picture p6: schematic 0.1.sch, sheet 6, OLED Displays I]

Parts:
C41: 100nF; C0805K
IC1: TCA9548A; TSSOP24
P2, P3, P4: 53048-0410
R59, R60, R61, R62, R63, R64, R65, R66, R67: 1k; R0805
U9, U10, U11: DISPLAY-OLED-128X32

Connections:
+3V3: C41.1, IC1.24 (VCC), P2.2, P3.2, P4.2, R59.2, R60.2, R61.2, R62.2, R63.2, R64.2, R65.2, R66.2, R67.2, U9.2 (VCC), U10.2 (VCC), U11.2 (VCC); also elsewhere on the board
GND: C41.2, IC1.12 (GND), IC1.21 (A2), P2.1, P3.1, P4.1, U9.1 (GND), U10.1 (GND), U11.1 (GND); also elsewhere on the board
I2C_1_SCL: IC1.22 (SCL), R67.1; also elsewhere on the board
I2C_1_SDA: IC1.23 (SDA), R66.1; also elsewhere on the board
I2C_MUX_0: IC1.1 (A0); also elsewhere on the board
I2C_MUX_1: IC1.2 (A1); also elsewhere on the board
I2C_RESET: IC1.3 (RESET), R65.1; also elsewhere on the board
SCL_OLED1: IC1.5 (SC0), P4.3, R60.1, U11.3 (SCL)
SCL_OLED2: IC1.7 (SC1), P3.3, R62.1, U10.3 (SCL)
SCL_OLED3: IC1.9 (SC2), P2.3, R64.1, U9.3 (SCL)
SDA_OLED1: IC1.4 (SD0), P4.4, R59.1, U11.4 (SDA)
SDA_OLED2: IC1.6 (SD1), P3.4, R61.1, U10.4 (SDA)
SDA_OLED3: IC1.8 (SD2), P2.4, R63.1, U9.4 (SDA)
