szymonkacperek/PSD_Dashboard/Projekt_EAGLE/0.1.brd

## EAGLE design Projekt_EAGLE/0.1.brd (continued)

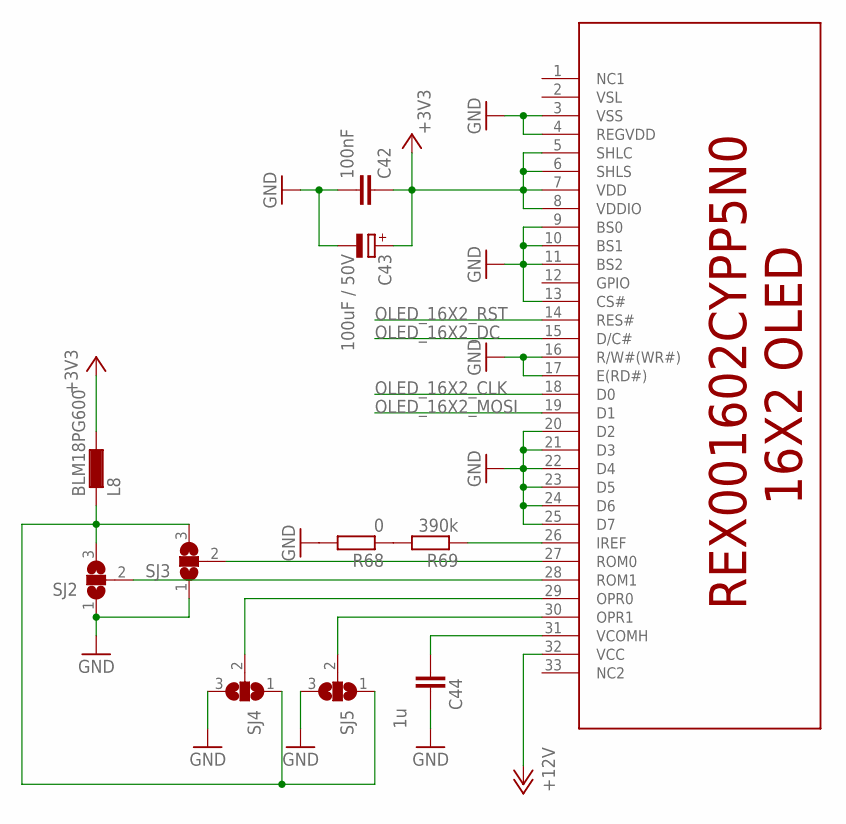
[picture p7: schematic 0.1.sch, sheet 7, OLED Displays II]

Parts:
C42: 100nF; C0805K
C43: 100uF / 50V; PANASONIC_F
C44: 1u; C0805K
DISPLAY1: REX001602CYPP5N0; 33PIN_LCD16X2
L8: BLM18PG600; L1608
R68: 0; R0805
R69: 390k; R0805
SJ2, SJ3, SJ4, SJ5: SJ2W; SJ_2

Connections:
+3V3: C42.1, C43.+, DISPLAY1.5 (SHLC), DISPLAY1.6 (SHLS), DISPLAY1.7 (VDD), DISPLAY1.8 (VDDIO), L8.1; also elsewhere on the board
+12V: DISPLAY1.32 (VCC); also elsewhere on the board
GND: C42.2, C43.-, C44.1, DISPLAY1.3 (VSS), DISPLAY1.4 (REGVDD), DISPLAY1.9 (BS0), DISPLAY1.10 (BS1), DISPLAY1.11 (BS2), DISPLAY1.13 (CS#), DISPLAY1.16 (R/W#(WR#)), DISPLAY1.17 (E(RD#)), DISPLAY1.20 (D2), DISPLAY1.21 (D3), DISPLAY1.22 (D4), DISPLAY1.23 (D5), DISPLAY1.24 (D6), DISPLAY1.25 (D7), R68.2, SJ2.1, SJ3.1, SJ4.3, SJ5.3; also elsewhere on the board
unnamed: DISPLAY1.26 (IREF), R69.1
unnamed: R68.1, R69.2
unnamed: DISPLAY1.27 (ROM0), SJ3.2
unnamed: DISPLAY1.28 (ROM1), SJ2.2
unnamed: C44.2, DISPLAY1.31 (VCOMH)
unnamed: L8.2, SJ2.3, SJ3.3, SJ4.1, SJ5.1
unnamed: DISPLAY1.30 (OPR1), SJ5.2
unnamed: DISPLAY1.29 (OPR0), SJ4.2
OLED_16X2_CLK: DISPLAY1.18 (D0); also elsewhere on the board
OLED_16X2_DC: DISPLAY1.15 (D/C#); also elsewhere on the board
OLED_16X2_MOSI: DISPLAY1.19 (D1); also elsewhere on the board
OLED_16X2_RST: DISPLAY1.14 (RES#); also elsewhere on the board

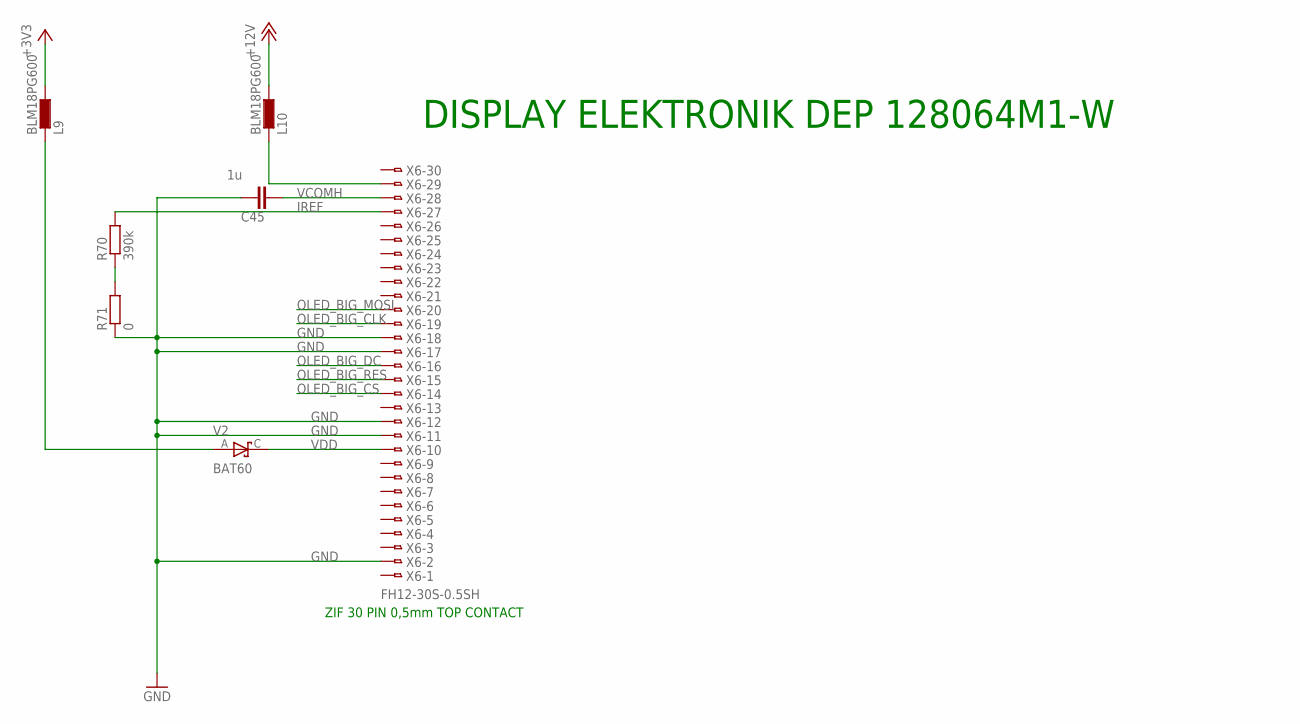
[picture p8: schematic 0.1.sch, sheet 8, OLED Displays III]

Parts:
C45: 1u; C0805K
L9, L10: BLM18PG600; L1608
R70: 390k; R0805
R71: 0; R0805
V2: BAT60; SOD323-R
X6: FH12-30S-0.5SH

Connections:
+3V3: L9.1; also elsewhere on the board
+12V: L10.1; also elsewhere on the board
GND: C45.1, R71.1, X6.2, X6.11, X6.12, X6.17, X6.18; also elsewhere on the board
IREF: R70.2, X6.27
unnamed: L10.2, X6.29
unnamed: L9.2, V2.A
unnamed: R70.1, R71.2
OLED_BIG_CLK: X6.19; also elsewhere on the board
OLED_BIG_CS: X6.14; also elsewhere on the board
OLED_BIG_DC: X6.16; also elsewhere on the board
OLED_BIG_MOSI: X6.20; also elsewhere on the board
OLED_BIG_RES: X6.15; also elsewhere on the board
VCOMH: C45.2, X6.28
VDD: V2.C, X6.10

Notes on the sheet:
DISPLAY ELEKTRONIK DEP 128064M1-W
ZIF 30 PIN 0,5mm TOP CONTACT

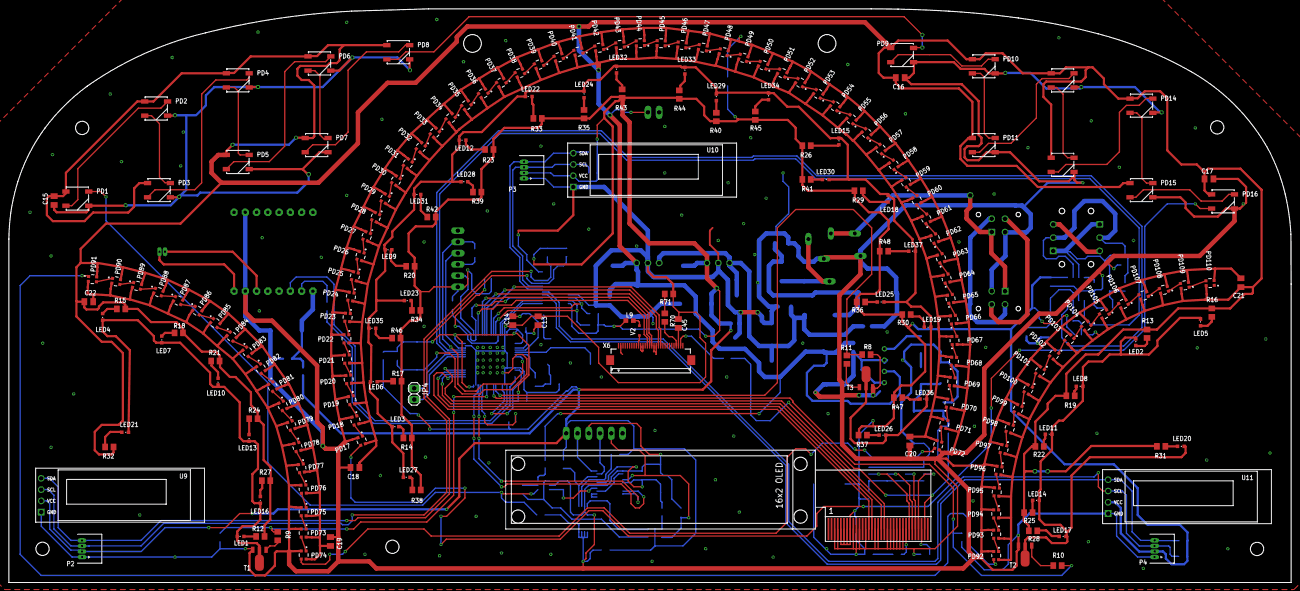
[picture p9: board 0.1.brd from above]

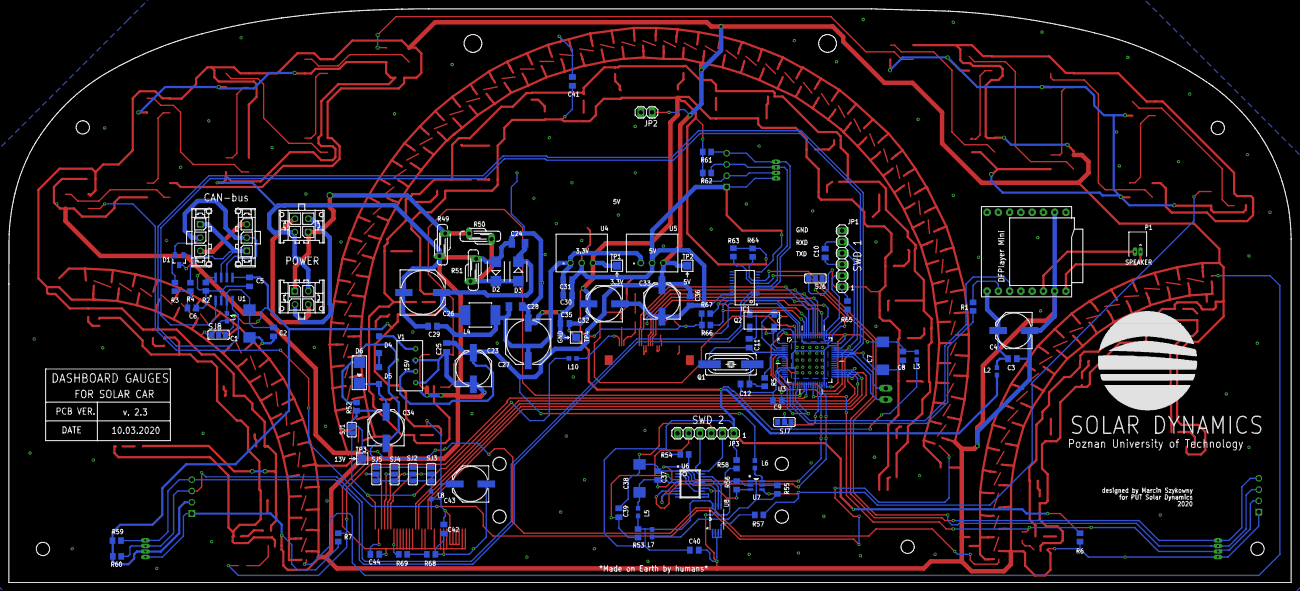
[picture p10: board 0.1.brd from below]

Board: 2 copper layers, 289.2 x 129.4 mm, 324 parts (109 on the bottom side), 245 nets.
