szymonkacperek/PSD_Dashboard/Dashboard_1.1/Src/main.c

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

/* Includes ------------------------------------------------------------------*/
#include "main.h"
#include "can.h"
#include "i2c.h"
#include "spi.h"
#include "tim.h"
#include "usart.h"
#include "gpio.h"

/* USER CODE BEGIN Includes */


#include "../GUI/gui.h"
#include "../GUI/gui.c"

#define SOFTWARE_VERSION "1.0"
#define SOFTWARE_RELASE_DATE "18.03.2019"


/* USER CODE END Includes */


/* USER CODE BEGIN PV */

/* USER CODE END PV */

void SystemClock_Config(void);
/* USER CODE BEGIN PFP */

/* USER CODE END PFP */

/**
  * @brief  The application entry point.
  * @retval int
  */
int main(void)
{
  /* USER CODE BEGIN 1 */

// HAL_DBGMCU_EnableDBGSleepMode();
// HAL_DBGMCU_DisableDBGStopMode();
// HAL_DBGMCU_EnableDBGStandbyMode();

  /* USER CODE END 1 */

  /* MCU Configuration--------------------------------------------------------*/

  /* Reset of all peripherals, Initializes the Flash interface and the Systick. */
  HAL_Init();

  /* Configure the system clock */
  SystemClock_Config();

  /* Initialize all configured peripherals */
  MX_GPIO_Init();
  MX_CAN_Init();
  MX_I2C1_Init();
  MX_SPI2_Init();
  MX_SPI3_Init();
  MX_TIM3_Init();
  MX_USART1_UART_Init();
  MX_USART2_UART_Init();
  MX_USART3_UART_Init();
  /* USER CODE BEGIN 2 */

	gui_init();
	gui_screen_intro(); //test

//	gui_test();

  /* USER CODE END 2 */

  /* Infinite loop */
  /* USER CODE BEGIN WHILE */
  while (1)
  {
    /* USER CODE END WHILE */

    /* USER CODE BEGIN 3 */

	  gui_screen_main();

  }
  /* USER CODE END 3 */
}

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
