szymonkacperek/PSD_Dashboard/Dashboard_1.1/Dashboard_1.1.ioc

Mcu.UserName=STM32F103RETx
PA10.Signal=USART1_RX
PA11.Signal=CAN_RX
PA12.Signal=CAN_TX
PA13.Signal=SYS_JTMS-SWDIO
PA14.Signal=SYS_JTCK-SWCLK
PA2.Signal=USART2_TX
PA3.Signal=USART2_RX
PA6.Signal=S_TIM3_CH1
PA7.Signal=S_TIM3_CH2
PA9.Signal=USART1_TX
PB0.Signal=S_TIM3_CH3
PB10.Signal=USART3_TX
PB11.Signal=USART3_RX
PB12.Signal=GPIO_Output
PB13.Signal=SPI2_SCK
PB14.Signal=GPIO_Output
PB15.Signal=SPI2_MOSI
PB3.Signal=SPI3_SCK
PB5.Signal=SPI3_MOSI
PB6.Signal=I2C1_SCL
PB7.Signal=I2C1_SDA
PB8.Signal=GPIO_Output
PB9.Signal=GPIO_Output
PC10.Signal=GPIO_Output
PC12.Signal=GPIO_Output
PC14-OSC32_IN.Signal=RCC_OSC32_IN
PC15-OSC32_OUT.Signal=RCC_OSC32_OUT
PD0-OSC_IN.Signal=RCC_OSC_IN
PD1-OSC_OUT.Signal=RCC_OSC_OUT
PD2.Signal=GPIO_Output
