szymonkacperek/PSD_Dashboard/Dashboard_1.1/PWM/pwm.c

/*
 * pwm.c
 *
 *  Created on: 17.01.2019
 *      Author: user
 */

#include "../PWM/pwm.h"
#include "stm32f1xx_hal.h"

void set_backlight(int bl)
{
	  TIM3->CCR1 = bl;
	  TIM3->CCR2 = bl;
	  TIM3->CCR3 = bl;
}

// PWM odpowiada za ustalenie jasnosci backlightu. Do generowania sygnalu potrzebny jest timer.
void pwm_init() {
	HAL_TIM_PWM_Start(&htim3, TIM_CHANNEL_1); // Uruchamia generowanie PWM przez timer 4 na kanale 1
	HAL_TIM_PWM_Start(&htim3, TIM_CHANNEL_2); // Uruchamia generowanie PWM przez timer 4 na kanale 2
	HAL_TIM_PWM_Start(&htim3, TIM_CHANNEL_3); // Uruchamia generowanie PWM przez timer 4 na kanale 3
}
