szymonkacperek/PSD_Dashboard/Dashboard_1.1/Inc/LCD.h

#ifndef LCD_H_
#define LCD_H_

#include "stm32f1xx_hal.h"
#include "string.h"
#include "main.h"
#include "spi.h"

/************************************** Command register **************************************/
#define CLEAR_DISPLAY 0x01

#define RETURN_HOME 0x02

#define ENTRY_MODE_SET 0x04
#define OPT_S	0x01					// Shift entire display to right
#define OPT_INC 0x02					// Cursor increment

#define DISPLAY_ON_OFF_CONTROL 0x08
#define OPT_D	0x04					// Turn on display
#define OPT_C	0x02					// Turn on cursor
#define OPT_B 	0x01					// Turn on cursor blink

#define CURSOR_DISPLAY_SHIFT 0x10		// Move and shift cursor
#define OPT_SC 0x08
#define OPT_RL 0x04

//#define FUNCTION_SET 0x20
#define FUNCTION_SET 0x08
#define OPT_DL 0x00
//#define OPT_DL 0x10						// Set interface data length
#define OPT_N 0x00
//#define OPT_N 0x08						// Set number of display lines
#define OPT_F 0x04						// Set alternate font

#define SET_DDRAM_ADDR 0x80				// Set DDRAM address


/************************************** Helper macros **************************************/
#define DELAY(X) HAL_Delay(X)


/************************************** LCD defines **************************************/
#define LCD_NIB 4
#define LCD_BYTE 8
#define LCD_DATA_REG 1
#define LCD_COMMAND_REG 0


/************************************** LCD typedefs **************************************/
#define Lcd_PortType GPIO_TypeDef*
#define Lcd_PinType uint16_t

typedef enum
{
	LCD_4_BIT_MODE,
	LCD_8_BIT_MODE
} Lcd_ModeTypeDef;


typedef struct {

} Lcd_HandleTypeDef;


/************************************** Public functions **************************************/
void Lcd_init();
void Lcd_int(int number);
void Lcd_string(char * string);
void Lcd_cursor(uint8_t row, uint8_t col);
void Lcd_clr();


#endif /* LCD_H_ */
