szymonkacperek/PSD_Dashboard/(commit log)

2020-07-21 Wgrany program testowy
    [Dashboard_1.1 Run.cfg, New_configuration.cfg, ws2812b Run.cfg]
2020-07-24 Poprawka vol. 2
    [Dashboard_1.1 Debug.cfg, New_configuration.cfg, ws2812b Run.cfg]
2020-07-24 Poprawka vol. 3
    [Dashboard_1.1 Debug.cfg, Dashboard_1.1 Run.cfg]
2020-08-05 Dostepne sa juz pliki .hex lub .bin do wgrania na procesor w obu projektach.
    [Dashboard_2.1.brd, Dashboard_2.1.sch, New_configuration.cfg, ws2812b Run.cfg]
2020-08-10 Uaktualniony schemat EAGLE.
    [0.1.brd, 0.1.sch]
2020-08-11 Wlaczony UART3 do komunikacji z F030
