szymonkacperek/PSD_Dashboard/(notices)

Notices in the files:
Dashboard_1.1/Src/main.c:
© Copyright (c) 2019 STMicroelectronics.
All rights reserved.
This software component is licensed by ST under BSD 3-Clause license,
the "License"; You may not use this file except in compliance with the
License. You may obtain a copy of the License at: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
(C) COPYRIGHT STMicroelectronics *****END OF FILE
parts and their libraries:
Eagle_STEP-DOWN-CONVERTER: Copyright: Würth Elektronik
diy-modules: Released under the Creative Commons Attribution 4.0 International License: http://creativecommons.org/licenses/by/4.0
con-molex-picoblade: Copyright (C) 2010, Bob Starr
